jwilts/ArduinoTimer/IMG_5379.jpg

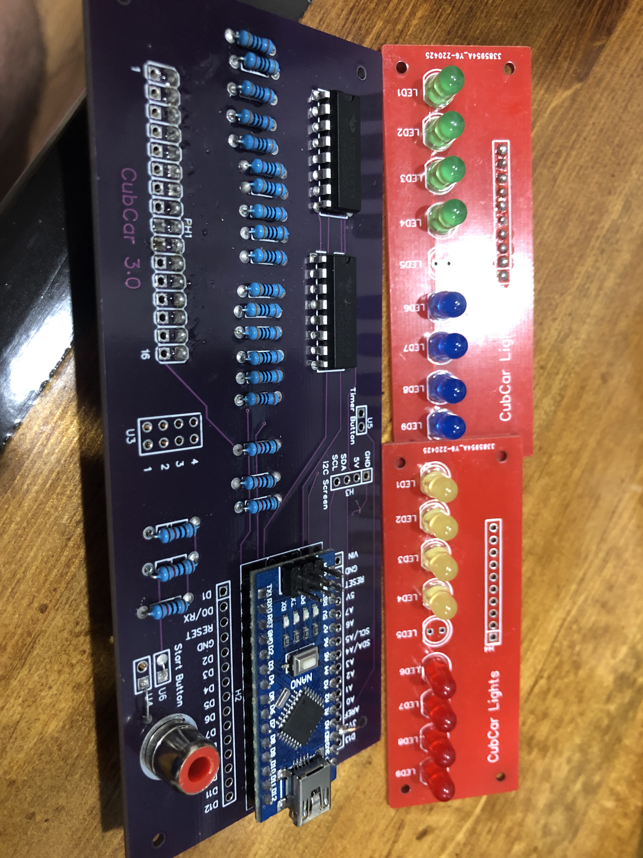
IMG_5379.jpg
